jelgerlemmens/toytrains-loco-decoder/KiCad_Project/toytrains_decoder_smd/toytrains_decoder_smd.kicad_pcb

## KiCad design KiCad_Project/toytrains_decoder_smd/toytrains_decoder_smd.kicad_pcb (2026-04-24)

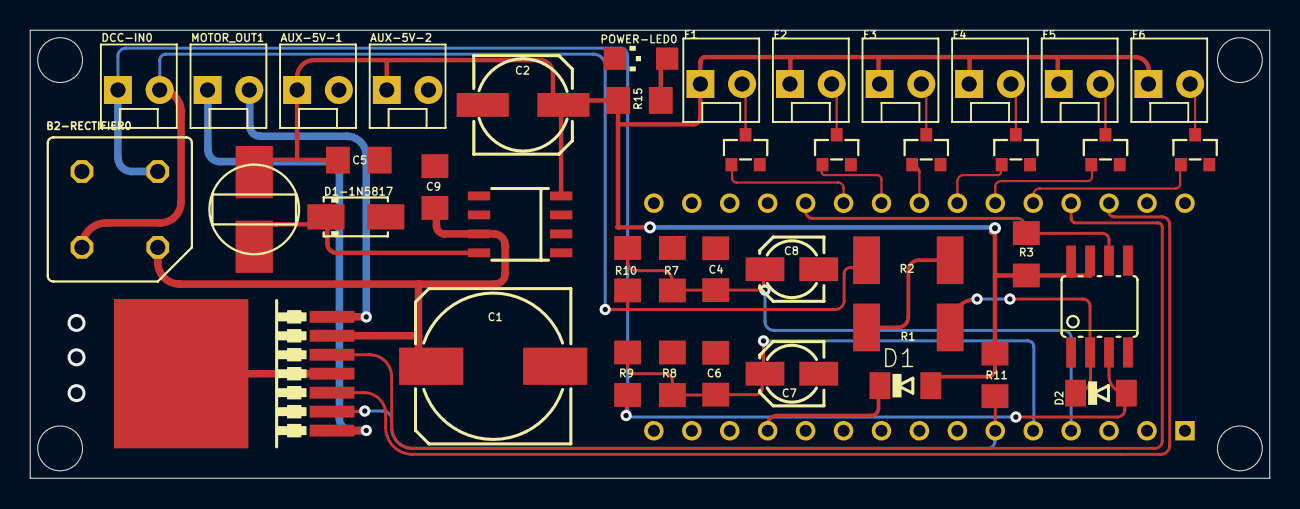
[picture p1: board toytrains_decoder_smd.kicad_pcb from above]

Board: 2 copper layers, 83.0 x 30.0 mm, 47 parts (1 on the bottom side), 30 nets.

Parts:
ARDUINO_NANO1: ARDUINO_NANO
AUX-5V-1, AUX-5V-2: 5V_OUT; MOLEX-1X2_LOCK_513
B2-RECTIFIER0: 2w10; 1KAB_336
C1: 470uF 35V; 153CLV-1014_334
C2: 100uF 10V; 153CLV-0605_334
C4, C5, C6, C9: 0.1uF; C1206_334
C7, C8: 22uF 16V; 153CLV-0405_334
D1, D2: MINIMELF; MINIMELF_210
D1-1N5817: S1A; DO214AC
DCC-IN0: MOLEX-1X2_LOCK_513
F1, F2, F3, F4, F5, F6: MOLEX-1X2_LOCK_513
IC1: TLE5206-2G; P-TO263-7-1
MOTOR_OUT1: MOLEX-1X2_LOCK_513
OK1: HCPL0601; SOIC08_320
POWER-LED0: CHIPLED_1206_259
Q1, Q2, Q3, Q4, Q5, Q6: BSS138; SOT23
R1, R2: 430Ω; R2512_334
R3: 1kΩ; R1206_334
R7, R8, R11: 2.2kΩ; R1206_334
R9, R10: 10kΩ; R1206_334
R15: 560Ω; R1206_334
U$1: LM2594; SOIC8
U$2: L-CD54; L_CD54
UNK_HOLE_0: dummyfp0
UNK_HOLE_1: dummyfp1
UNK_HOLE_2: dummyfp2
UNK_HOLE_3: dummyfp3

Connections:
5V: AUX-5V-1.1, AUX-5V-2.1, C2.+, C5.1, D1.A, F1.1, F2.1, F3.1, F4.1, F5.1, F6.1, OK1.7, OK1.8, R3.2, R11.1, R15.1, U$1.4, U$2.P$2
20V: B2-RECTIFIER0.+, C1.+, C9.1, IC1.6, U$1.7
GND: ARDUINO_NANO1.14, ARDUINO_NANO1.19, AUX-5V-1.2, AUX-5V-2.2, B2-RECTIFIER0.-, C1.-, C2.-, C4.1, C5.2, C6.2, C7.-, C8.-, C9.2, D1-1N5817.A, IC1.4, IC1.8, OK1.5, POWER-LED0.C, Q1.2, Q2.2, Q3.2, Q4.2, Q5.2, Q6.2, R7.2, R8.2, U$1.5, U$1.6
HV-DCC-SIG-ONE: B2-RECTIFIER0.AC2, D2.A, DCC-IN0.1, OK1.3, R9.1
HV-DCC-SIG-TWO: B2-RECTIFIER0.AC1, DCC-IN0.2, R2.2, R10.1
unnamed: D1-1N5817.C, U$1.8, U$2.P$1
unnamed: ARDUINO_NANO1.22, Q5.1
unnamed: D2.C, OK1.2, R1.1
unnamed: ARDUINO_NANO1.6, IC1.2, R11.2
unnamed: R1.2, R2.1
unnamed: IC1.7, MOTOR_OUT1.2
unnamed: ARDUINO_NANO1.5, C6.1, C7.+, R8.1, R9.2
unnamed: ARDUINO_NANO1.28, IC1.3
unnamed: ARDUINO_NANO1.27, IC1.5
unnamed: ARDUINO_NANO1.21, Q6.1
unnamed: ARDUINO_NANO1.4, C4.2, C8.+, R7.1, R10.2
unnamed: ARDUINO_NANO1.23, Q4.1
unnamed: ARDUINO_NANO1.24, Q3.1
unnamed: ARDUINO_NANO1.25, Q2.1
unnamed: ARDUINO_NANO1.26, Q1.1
unnamed: F6.2, Q1.3
unnamed: F5.2, Q2.3
unnamed: F3.2, Q4.3
unnamed: ARDUINO_NANO1.20, OK1.6, R3.1
unnamed: IC1.1, MOTOR_OUT1.1
unnamed: POWER-LED0.A, R15.2
unnamed: ARDUINO_NANO1.12, D1.C
unnamed: F4.2, Q3.3
unnamed: F2.2, Q5.3
unnamed: F1.2, Q6.3
