jelgerlemmens/toytrains-loco-decoder/Eagle_Project/Decoder_SMD/CAB_decoder_SMD.brd

## EAGLE design Eagle_Project/Decoder_SMD/CAB_decoder_SMD.brd (2021-02-11)

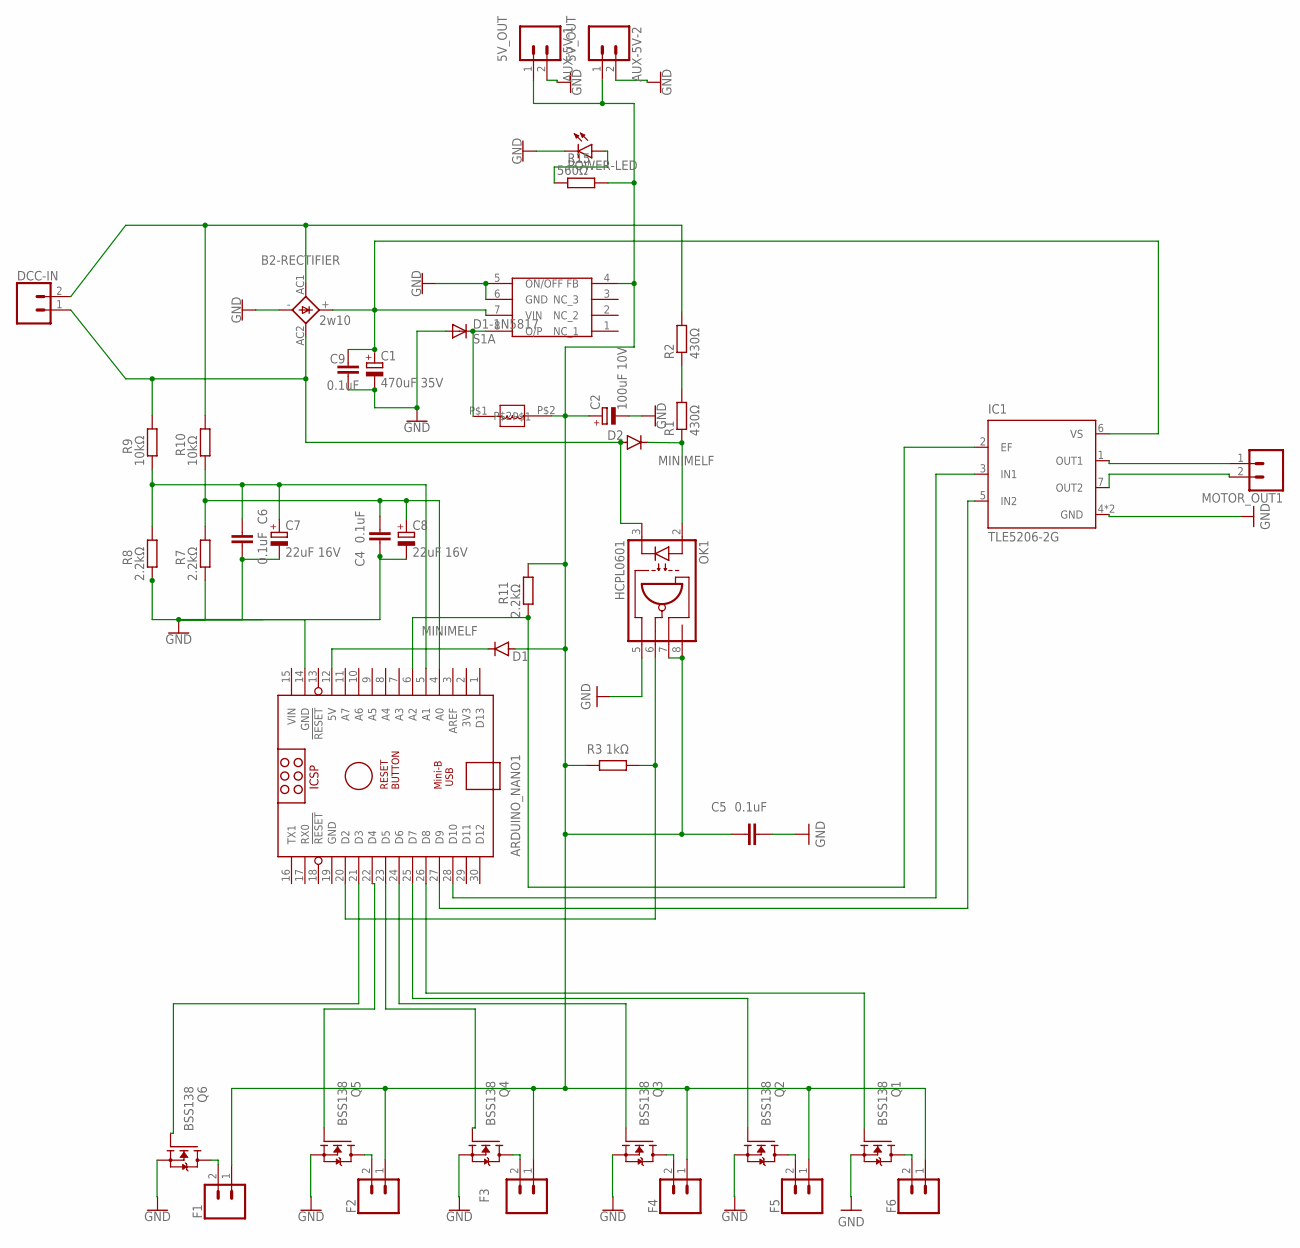
[picture p2: schematic CAB_decoder_SMD.sch]

Parts:
ARDUINO_NANO1: ARDUINO_NANO
AUX-5V-1, AUX-5V-2: 5V_OUT; MOLEX-1X2_LOCK
B2-RECTIFIER: 2w10; 1KAB
C1: 470uF 35V; 153CLV-1014
C2: 100uF 10V; 153CLV-0605
C4, C5, C6, C9: 0.1uF; C1206
C7, C8: 22uF 16V; 153CLV-0405
D1, D2: MINIMELF
D1-1N5817: S1A; DO214AC
DCC-IN: CONN_02POLAR_LOCK; MOLEX-1X2_LOCK
F1, F2, F3, F4, F5, F6: CONN_02POLAR_LOCK; MOLEX-1X2_LOCK
IC1: TLE5206-2G; P-TO263-7-1
MOTOR_OUT1: CONN_02POLAR_LOCK; MOLEX-1X2_LOCK
OK1: HCPL0601; SOIC08
POWER-LED: LEDCHIPLED_1206; CHIPLED_1206
Q1, Q2, Q3, Q4, Q5, Q6: BSS138; SOT23
R1, R2: 430Ω; R2512
R3: 1kΩ; R1206
R7, R8, R11: 2.2kΩ; R1206
R9, R10: 10kΩ; R1206
R15: 560Ω; R1206
U$1: LM2594; SOIC8
U$2: L-CD54; L_CD54

Connections:
5V: AUX-5V-1.1, AUX-5V-2.1, C2.+, C5.1, D1.A, F1.1, F2.1, F3.1, F4.1, F5.1, F6.1, OK1.7 (VE), OK1.8 (VCC), R3.2, R11.1, R15.1, U$1.4 (FB), U$2.P$2
20V: B2-RECTIFIER.+, C1.+, C9.1, IC1.6 (VS), U$1.7 (VIN)
GND: ARDUINO_NANO1.14 (GND), ARDUINO_NANO1.19 (GND), AUX-5V-1.2, AUX-5V-2.2, B2-RECTIFIER.-, C1.-, C2.-, C4.1, C5.2, C6.2, C7.-, C8.-, C9.2, D1-1N5817.A, IC1.4 (GND), IC1.8 (GND), OK1.5 (GND), POWER-LED.C, Q1.2 (S), Q2.2 (S), Q3.2 (S), Q4.2 (S), Q5.2 (S), Q6.2 (S), R7.2, R8.2, U$1.5 (ON/OFF), U$1.6 (GND)
HV-DCC-SIG-ONE: B2-RECTIFIER.AC2, D2.A, DCC-IN.1, OK1.3 (C), R9.1
HV-DCC-SIG-TWO: B2-RECTIFIER.AC1, DCC-IN.2, R2.2, R10.1
unnamed: D1-1N5817.C, U$1.8 (O/P), U$2.P$1
unnamed: ARDUINO_NANO1.22 (D4), Q5.1 (G)
unnamed: D2.C, OK1.2 (A), R1.1
unnamed: ARDUINO_NANO1.6 (A2), IC1.2 (EF), R11.2
unnamed: R1.2, R2.1
unnamed: IC1.7 (OUT2), MOTOR_OUT1.2
unnamed: ARDUINO_NANO1.5 (A1), C6.1, C7.+, R8.1, R9.2
unnamed: ARDUINO_NANO1.28 (D10), IC1.3 (IN1)
unnamed: ARDUINO_NANO1.27 (D9), IC1.5 (IN2)
unnamed: ARDUINO_NANO1.21 (D3), Q6.1 (G)
unnamed: ARDUINO_NANO1.4 (A0), C4.2, C8.+, R7.1, R10.2
unnamed: ARDUINO_NANO1.23 (D5), Q4.1 (G)
unnamed: ARDUINO_NANO1.24 (D6), Q3.1 (G)
unnamed: ARDUINO_NANO1.25 (D7), Q2.1 (G)
unnamed: ARDUINO_NANO1.26 (D8), Q1.1 (G)
unnamed: F6.2, Q1.3 (D)
unnamed: F5.2, Q2.3 (D)
unnamed: F3.2, Q4.3 (D)
unnamed: ARDUINO_NANO1.20 (D2), OK1.6 (VO), R3.1
unnamed: IC1.1 (OUT1), MOTOR_OUT1.1
unnamed: POWER-LED.A, R15.2
unnamed: ARDUINO_NANO1.12 (5V), D1.C
unnamed: F4.2, Q3.3 (D)
unnamed: F2.2, Q5.3 (D)
unnamed: F1.2, Q6.3 (D)
VIN: ARDUINO_NANO1.15 (VIN)

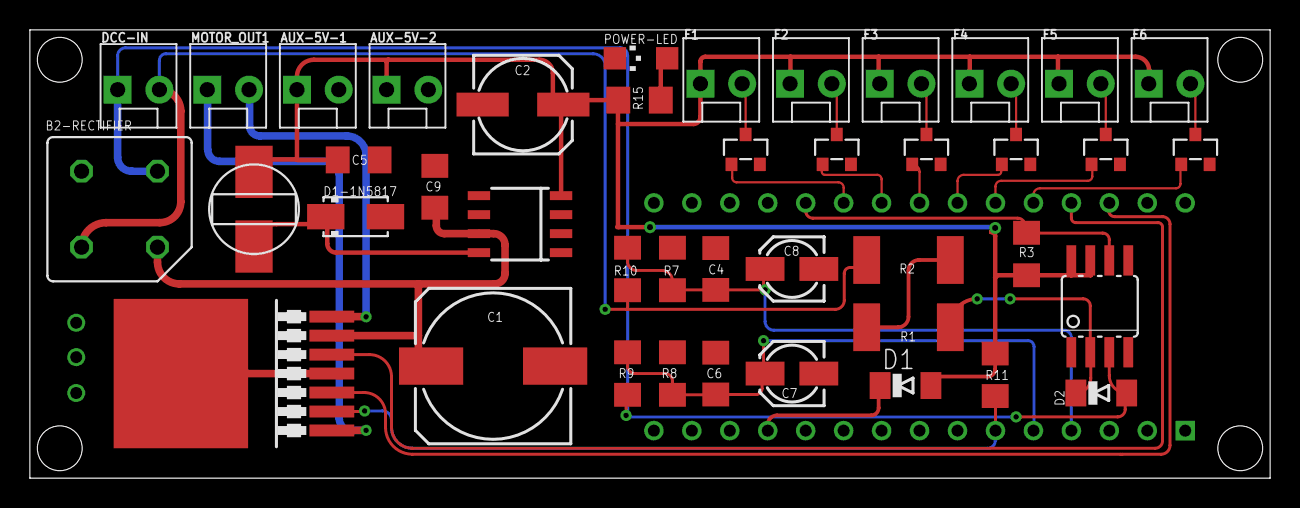
[picture p3: board CAB_decoder_SMD.brd from above]

Board: 2 copper layers, 83.0 x 30.0 mm, 43 parts (1 on the bottom side), 30 nets.
