jelgerlemmens/toytrains-loco-decoder/(commit log)

2021-02-11 Included AutoDesk Eagle designs
    [CAB_decoder_SMD.brd, CAB_decoder_SMD.sch]
2026-04-16 Migrate to PlatformIO, fix bugs, optimise motor control
    - Converted .ino to .cpp, restructured into PlatformIO layout (src/include/lib)
    - Fixed Persist::getState() defaulting to INITIAL on fresh/corrupt EEPROM
    - Fixed FunctionController out-of-bounds array indexing in function groups 2/3
    - Fixed EvaluateFunctionGroupFive calling GroupFour (copy-paste bug)
    - Fixed CVPair stored by value to prevent dangling pointer
    - Guard EEPROM writes in ExecuteFunctions behind currentState change check
    - Fix speed mapping to use SpeedSteps instead of hardcoded 126 (correct for 14/28/128-step modes)
    - DCC address default: 3 → 25
    - Added KiCad PCB project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
    [CAB_decoder_SMD_1.kicad_sch, toytrains_decoder_smd.kicad_pcb, toytrains_decoder_smd.kicad_sch]
2026-04-17 Horn: add PinType/HORN_PIN, update PinController for momentary pulse
    - Structs.h: add PinType enum (DIGITAL, MOMENTARY_PULSE) and pinType
    field to PinPair
    - UserConfig.h: add HORN_PIN 8 (DFPlayer Mini IO_1 via BSS138 FET)
    - PinController: FillPins sets horn pin to MOMENTARY_PULSE/LOW, others
    to DIGITAL/LOW; SetPins uses stored State; SetPinState fires piezo
    tone pattern on MOMENTARY_PULSE activation, no-op on deactivation
    - DccDecoder: default address 25 → 7; remove speed debug logging from
    notifyDccSpeed (was flooding serial under DEBUG flag)
2026-04-17 KiCad: add rev2 schematic and update PCB design files
    - Add CAB_decoder_SMD_rev2.kicad_sch (PCB revision in progress)
    - Add eagle import symbol library and sym-lib-table
    - Add top.kicad_sch sheet
    - Update main schematic and project files
    - Gitignore KiCad lock files, backups, .history, .vscode, .claude
    [CAB_decoder_SMD_rev2.kicad_sch, top.kicad_sch, toytrains_decoder_smd.kicad_sch]
2026-04-24 esp32_decoder kicad setup
    [.kicad_sch, .kicad_sch.kicad_sch, CAB_decoder_SMD_rev2.kicad_sch, rev_2.kicad_pcb, rev_2.kicad_sch, toytrains_decode_REV_2.kicad_pcb, toytrains_decode_REV_2.kicad_sch, toytrains_decoder_smd.kicad_pcb]
